feffe81/fpv-cockpit-controller/(commit log)

2025-05-03 Update rudder-pedal-mixer.ino
    It works on my machine :-)
2025-05-07 More docs (#2)
    * Create test
    * Add files via upload
    * Delete images/test
    * Update README.md
    * Update README.md
    * Update README.md
    * bugfix flickering signals when analog read after calibration is exceeding the range
    * Add files via upload
    * Update README.md
    * Delete images/Circuit Schematic_Schaltplan.png
    * Add files via upload
    * more docs
    * Add files via upload
    * Update README.md
    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
    [rudder-pedal-mixer.ino]
2025-05-19 Added more documentation (#3)
    * image of full setup
    * Improve calculation accuracy (bugfix :-))
    * Update rudder-pedal-mixer.ino
    * Fix calibration branch condition
    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
    [rudder-pedal-mixer.ino]
2025-05-24 Add wired headtracker inpu
